SethDrake/monitor/main_module.brd

## EAGLE design main_module.brd (2017-12-04)

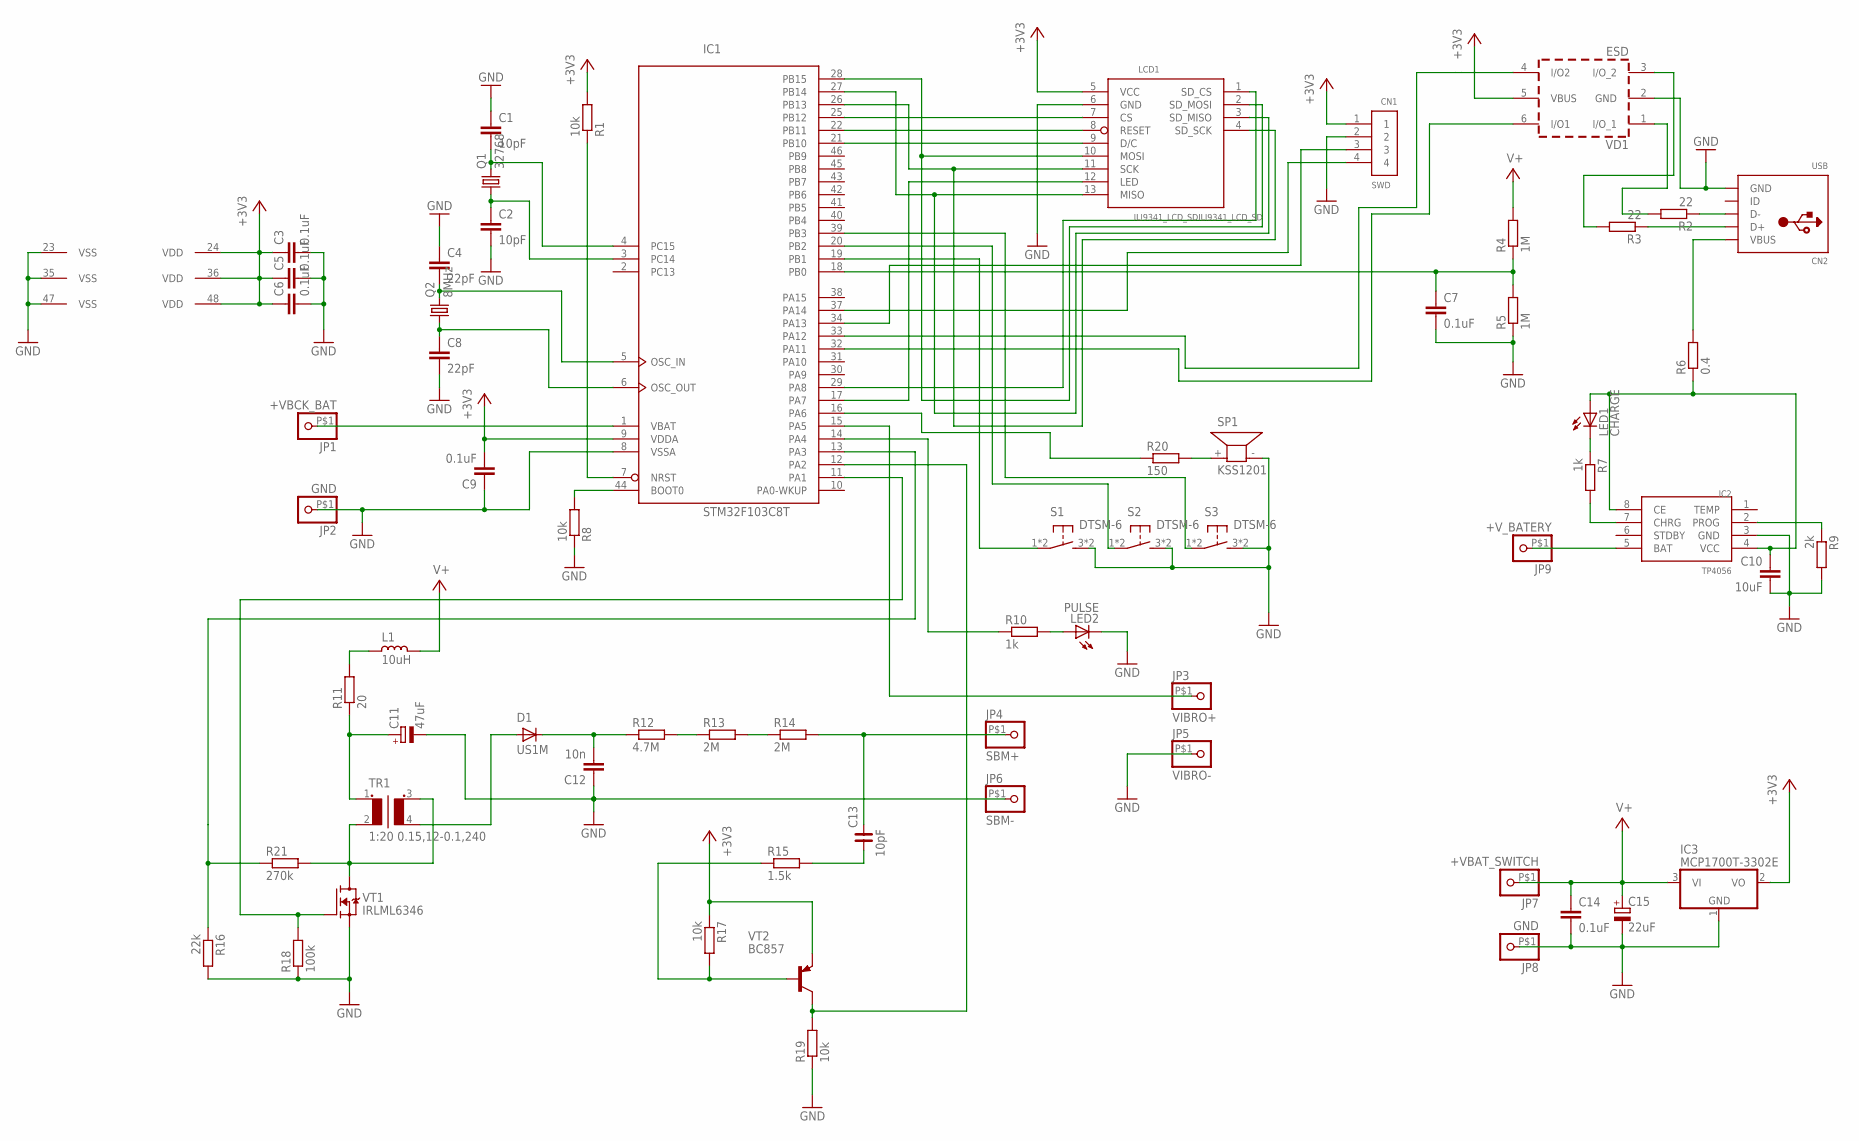
[picture p1: schematic main_module.sch]

Parts:
C1, C2: 10pF; C0805
C3, C5, C6, C7, C9, C14: 0.1uF; C0805
C4, C8: 22pF; C0805
C10: 10uF; C0805
C11: 47uF; C/6032-28R
C12: 10n; C1206
C13: 10pF; C1206
C15: 22uF; C/6032-28R
CN1: SWD; 1X04-BIG
CN2: USB; USB-MINIB
D1: US1M; SMA-DO214AC
IC1: STM32F103C8T; LQFP48
IC2: TP4056; SOP-8
IC3: MCP1700T-3302E; SOT23
JP1: +VBCK_BAT; 1X1-BIGPOGO
JP2, JP8: GND; 1X1-BIGPOGO
JP3: VIBRO+; 1X1-BIGPOGO
JP4: SBM+; 1X1-BIGPOGO
JP5: VIBRO-; 1X1-BIGPOGO
JP6: SBM-; 1X1-BIGPOGO
JP7: +VBAT_SWITCH; 1X1-BIGPOGO
JP9: +V_BATERY; 1X1-BIGPOGO
L1: 10uH; L0805
LCD1: ILI9341_LCD_SDILI9341_LCD_SD; ILI9341_LCD_SD
LED1: CHARGE; CHIP-LED0805
LED2: PULSE; LED3MM
Q1: 32768; HC49/S
Q2: 8MHz; HC49/S
R1, R8, R17, R19: 10k; M0805
R2, R3: 22; M0805
R4, R5: 1M; M0805
R6: 0.4; M1206
R7, R10: 1k; M0805
R9: 2k; M0805
R11: 20; M0805
R12: 4.7M; M0805
R13, R14: 2M; M0805
R15: 1.5k; M0805
R16: 22k; M0805
R18: 100k; M0805
R20: 150; M0805
R21: 270k; M0805
S1, S2, S3: DTSM-6
SP1: KSS1201
TR1: 1:20 0.15,12-0.1,240; RING-TRANS
VD1: ESD; SOT-23-6L
VT1: IRLML6346; SOT23
VT2: BC857; SOT23-BCE

Connections:
32OSC_IN: C1.2, IC1.4 (PC15), Q1.2
32OSC_OUT: C2.1, IC1.3 (PC14), Q1.1
+3V3: C3.1, C5.1, C6.1, C9.2, CN1.1, IC1.9 (VDDA), IC1.24 (VDD), IC1.36 (VDD), IC1.48 (VDD), IC3.2 (VO), LCD1.5 (VCC), R1.2, R17.1, VD1.5 (VBUS), VT2.E
+VBCK_BAT: IC1.1 (VBAT), JP1.P$1
+V_BATTERY: IC2.5 (BAT), JP9.P$1
BATT_CTRL: C7.1, IC1.18 (PB0), R4.1, R5.2
GND: C1.1, C2.2, C3.2, C4.1, C5.2, C6.2, C7.2, C8.2, C9.1, C10.2, C11.-, C12.1, C14.2, C15.-, CN1.2, CN2.GND, IC1.8 (VSSA), IC1.23 (VSS), IC1.35 (VSS), IC1.47 (VSS), IC2.3 (GND), IC3.1 (GND), JP2.P$1, JP5.P$1, JP6.P$1, JP8.P$1, LCD1.6 (GND), LED2.K (C), R5.1, R8.1, R9.2, R16.2, R18.1, R19.1, S1.3, S1.4 (3), S2.3, S2.4 (3), S3.3, S3.4 (3), SP1.- (2), VD1.2 (GND), VT1.2 (S)
HV_OUT: C12.2, D1.K (C), R12.1
HV_PULSE: IC1.12 (PA2), R19.2, VT2.C
HV_PUMP: IC1.11 (PA1), R18.2, VT1.1 (G)
HV_TEST: IC1.13 (PA3), R16.1, R21.1
HV_TR_OUT: D1.A, TR1.4 (S2)
KEY1: IC1.19 (PB1), S1.1, S1.2 (1)
KEY2: IC1.20 (PB2), S2.1, S2.2 (1)
KEY3: IC1.39 (PB3), S3.1, S3.2 (1)
LCD_BACKLIGHT: IC1.17 (PA7), LCD1.12 (LED)
LCD_CS: IC1.25 (PB12), LCD1.7 (CS)
LCD_RESET: IC1.22 (PB11), LCD1.8 (RESET)
LCD_RS: IC1.21 (PB10), LCD1.9 (D/C)
LED_PULSE: IC1.14 (PA4), R10.1
MISO: IC1.27 (PB14), LCD1.3 (SD_MISO), LCD1.13 (MISO)
MOSI: IC1.28 (PB15), LCD1.2 (SD_MOSI), LCD1.10 (MOSI)
unnamed: R13.2, R14.1
unnamed: R20.2, SP1.+ (1)
unnamed: R12.2, R13.1
unnamed: IC1.7 (NRST), R1.1
unnamed: L1.2, R11.2
unnamed: C13.1, R15.2
unnamed: C10.1, IC2.4 (VCC), IC2.8 (CE), LED1.A, R6.1
unnamed: LED2.A, R10.2
unnamed: R15.1, R17.2, VT2.B
unnamed: C11.+, R11.1, TR1.1
unnamed: IC1.44 (BOOT0), R8.2
unnamed: CN2.D-, R2.1
unnamed: CN2.D+, R3.1
unnamed: IC2.2 (PROG), R9.1
unnamed: R21.2, TR1.2, TR1.3 (S1), VT1.3 (D)
unnamed: IC2.7 (CHRG), R7.2
unnamed: LED1.C, R7.1
OSC_IN: C4.2, IC1.5 (OSC_IN), Q2.2
OSC_OUT: C8.1, IC1.6 (OSC_OUT), Q2.1
SBM+: C13.2, JP4.P$1, R14.2
SCK: IC1.26 (PB13), LCD1.4 (SD_SCK), LCD1.11 (SCK)
SD_CS: IC1.29 (PA8), LCD1.1 (SD_CS)
SOUND: IC1.16 (PA6), R20.1
SWCLK: CN1.4, IC1.37 (PA14)
SWDIO: CN1.3, IC1.34 (PA13)
USB_DM: IC1.32 (PA11), VD1.6 (I/O1)
USB_DM_PROT: R2.2, VD1.1 (I/O_1)
USB_DP: IC1.33 (PA12), VD1.4 (I/O2)
USB_DP_PROT: R3.2, VD1.3 (I/O_2)
USB_POWER: CN2.VBUS, R6.2
V+: C14.1, C15.+, IC3.3 (VI), JP7.P$1, L1.1, R4.2
VIBRO: IC1.15 (PA5), JP3.P$1

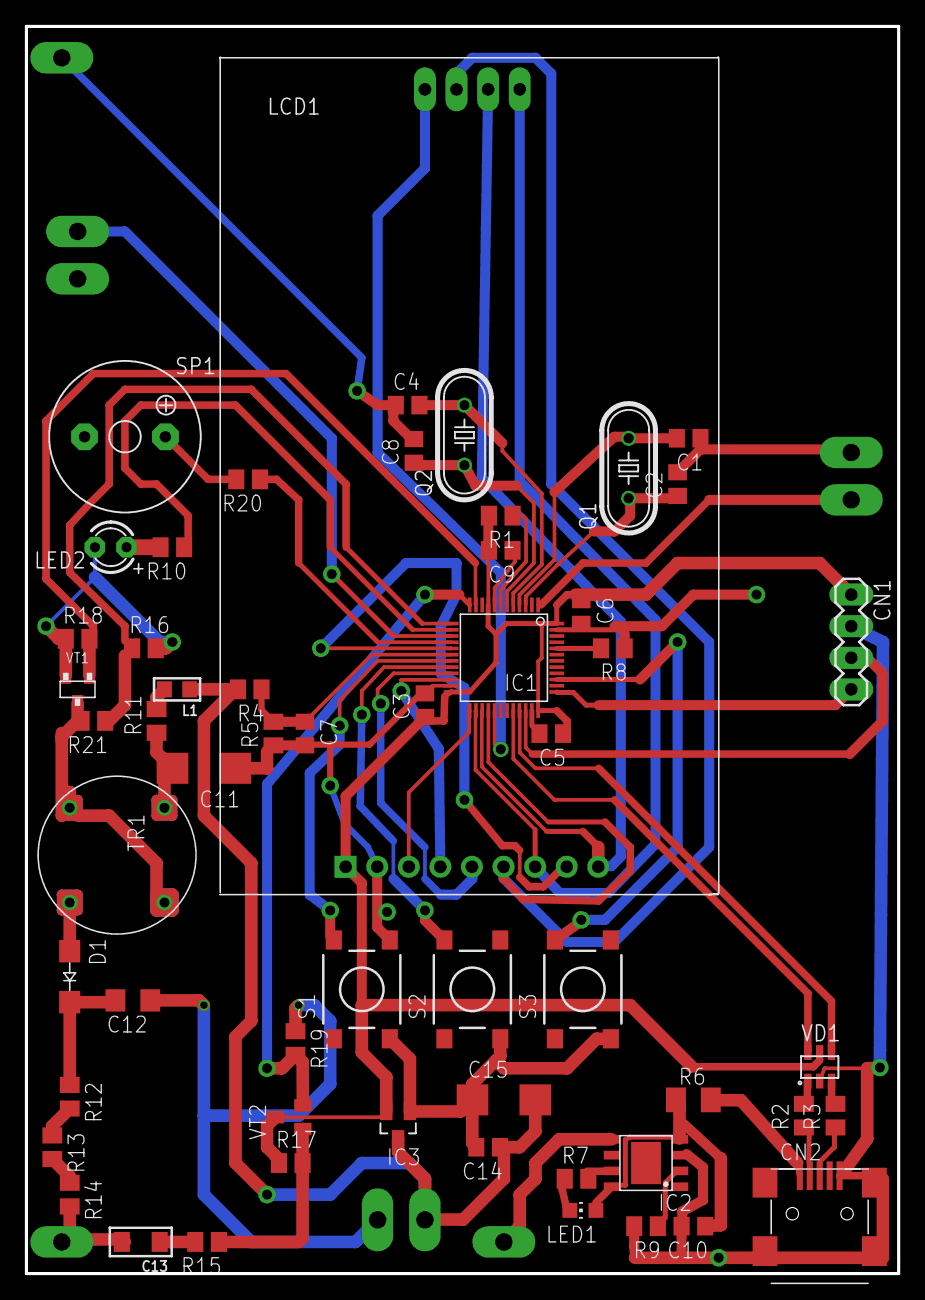
[picture p2: board main_module.brd from above]

Board: 2 copper layers, 70.2 x 100.3 mm, 65 parts (0 on the bottom side), 54 nets.
