SethDrake/monitor/main_module.0.1.brd

## EAGLE design main_module.0.1.brd (2017-04-18)

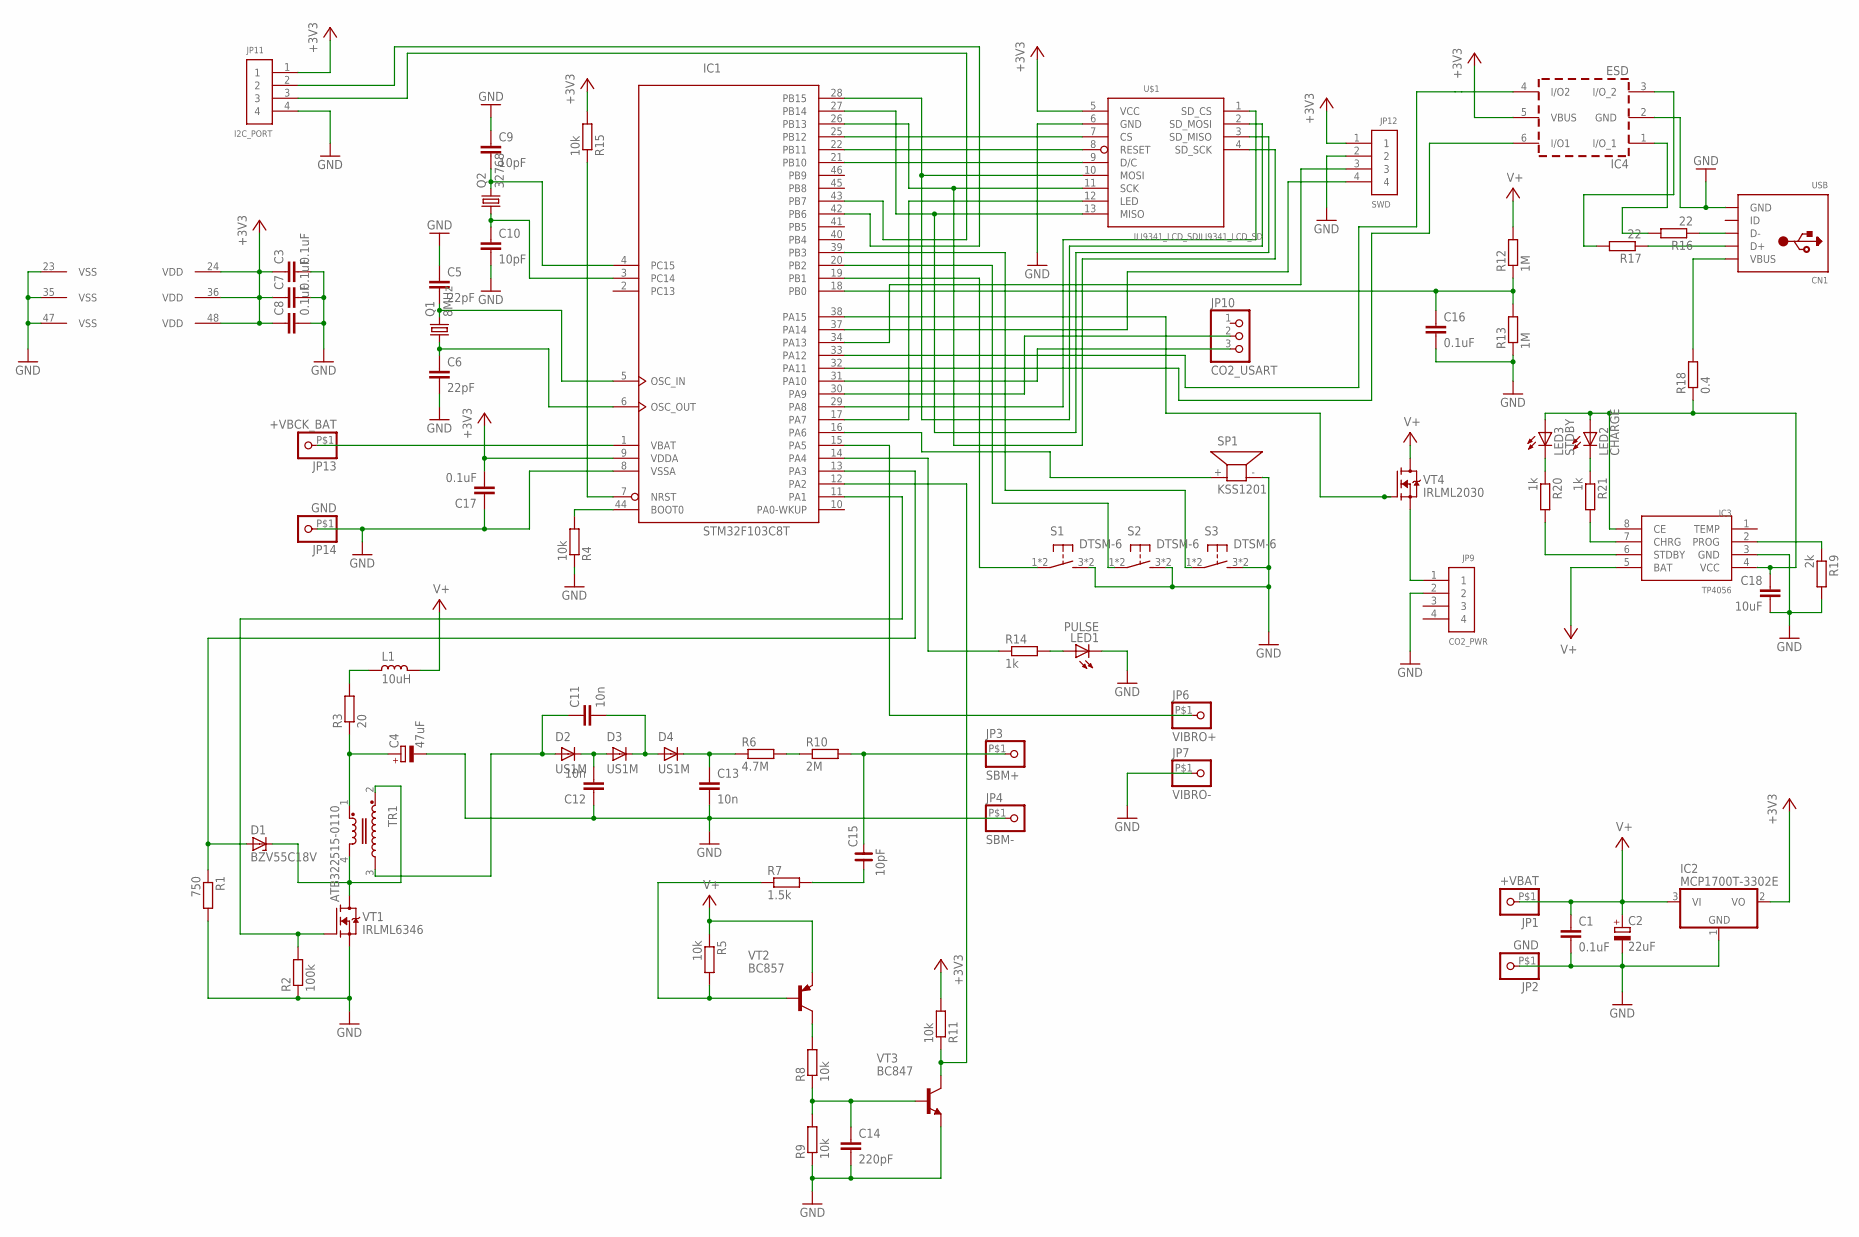
[picture p3: schematic main_module.0.1.sch]

Parts:
C1, C3, C7, C8, C16, C17: 0.1uF; C0805
C2: 22uF; C/6032-28R
C4: 47uF; C/6032-28R
C5, C6: 22pF; C0805
C9, C10: 10pF; C0805
C11, C12, C13: 10n; C1206
C14: 220pF; C0805
C15: 10pF; C1206
C18: 10uF; C0805
CN1: USB; USB-MINIB
D1: BZV55C18V; SOD80C
D2, D3, D4: US1M; SMA-DO214AC
IC1: STM32F103C8T; LQFP48
IC2: MCP1700T-3302E; SOT23
IC3: TP4056; SOP-8
IC4: ESD; SOT-23-6L
JP1: +VBAT; 1X1-BIGPOGO
JP2, JP14: GND; 1X1-BIGPOGO
JP3: SBM+; 1X1-BIGPOGO
JP4: SBM-; 1X1-BIGPOGO
JP6: VIBRO+; 1X1-BIGPOGO
JP7: VIBRO-; 1X1-BIGPOGO
JP9: CO2_PWR; 1X04-BIG
JP10: CO2_USART; 1X03
JP11: I2C_PORT; 1X04-BIG
JP12: SWD; 1X04-BIG
JP13: +VBCK_BAT; 1X1-BIGPOGO
L1: 10uH; L0805
LED1: PULSE; LED3MM
LED2: CHARGE; CHIP-LED0805
LED3: STDBY; CHIP-LED0805
Q1: 8MHz; HC49/S
Q2: 32768; HC49/S
R1: 750; M0805
R2: 100k; M0805
R3: 20; M0805
R4, R5, R8, R9, R11, R15: 10k; M0805
R6: 4.7M; M0805
R7: 1.5k; M0805
R10: 2M; M0805
R12, R13: 1M; M0805
R14, R20, R21: 1k; M0805
R16, R17: 22; M0805
R18: 0.4; M1206
R19: 2k; M0805
S1, S2, S3: DTSM-6
SP1: KSS1201
TR1: ATB322515-0110; ATB3225
U$1: ILI9341_LCD_SDILI9341_LCD_SD; ILI9341_LCD_SD
VT1: IRLML6346; SOT23
VT2: BC857; SOT23-BCE
VT3: BC847; SOT23
VT4: IRLML2030; SOT23

Connections:
32OSC_IN: C9.2, IC1.4 (PC15), Q2.2
32OSC_OUT: C10.1, IC1.3 (PC14), Q2.1
+3V3: C3.1, C7.1, C8.1, C17.2, IC1.9 (VDDA), IC1.24 (VDD), IC1.36 (VDD), IC1.48 (VDD), IC2.2 (VO), IC4.5 (VBUS), JP11.1, JP12.1, R11.2, R15.2, U$1.5 (VCC)
+VBCK_BAT: IC1.1 (VBAT), JP13.P$1
BATT_CTRL: C16.1, IC1.18 (PB0), R12.1, R13.2
CO2_PWR_CONTROL: IC1.38 (PA15), VT4.1 (G)
GND: C1.2, C2.-, C3.2, C4.-, C5.1, C6.2, C7.2, C8.2, C9.1, C10.2, C12.1, C13.2, C14.2, C16.2, C17.1, C18.2, CN1.GND, IC1.8 (VSSA), IC1.23 (VSS), IC1.35 (VSS), IC1.47 (VSS), IC2.1 (GND), IC3.3 (GND), IC4.2 (GND), JP2.P$1, JP4.P$1, JP7.P$1, JP9.2, JP11.4, JP12.2, JP14.P$1, LED1.K (C), R1.2, R2.1, R4.1, R9.1, R13.1, R19.2, S1.3, S1.4 (3), S2.3, S2.4 (3), S3.3, S3.4 (3), SP1.- (2), U$1.6 (GND), VT1.2 (S), VT3.2 (E)
HV_MUL_IN: C11.1, D2.A, TR1.3
HV_PULSE: IC1.12 (PA2), R11.1, VT3.3 (C)
HV_PUMP: IC1.11 (PA1), R2.2, VT1.1 (G)
HV_TEST: D1.A, IC1.13 (PA3), R1.1
I2C_SCL: IC1.42 (PB6), JP11.2
I2C_SDA: IC1.43 (PB7), JP11.3
KEY1: IC1.19 (PB1), S1.1, S1.2 (1)
KEY2: IC1.20 (PB2), S2.1, S2.2 (1)
KEY3: IC1.39 (PB3), S3.1, S3.2 (1)
LCD_BACKLIGHT: IC1.17 (PA7), U$1.12 (LED)
LCD_CS: IC1.25 (PB12), U$1.7 (CS)
LCD_RESET: IC1.22 (PB11), U$1.8 (RESET)
LCD_RS: IC1.21 (PB10), U$1.9 (D/C)
LED_PULSE: IC1.14 (PA4), R14.1
MISO: IC1.27 (PB14), U$1.3 (SD_MISO), U$1.13 (MISO)
MOSI: IC1.28 (PB15), U$1.2 (SD_MOSI), U$1.10 (MOSI)
unnamed: JP9.1, VT4.2 (S)
unnamed: C12.2, D2.K (C), D3.A
unnamed: C11.2, D3.K (C), D4.A
unnamed: C13.1, D4.K (C), R6.1
unnamed: R6.2, R10.1
unnamed: IC1.7 (NRST), R15.1
unnamed: L1.2, R3.2
unnamed: C15.1, R7.2
unnamed: C18.1, IC3.4 (VCC), IC3.8 (CE), LED2.A, LED3.A, R18.1
unnamed: LED1.A, R14.2
unnamed: R5.2, R7.1, VT2.B
unnamed: R8.2, VT2.C
unnamed: C14.1, R8.1, R9.2, VT3.1 (B)
unnamed: C4.+, R3.1, TR1.1
unnamed: IC1.44 (BOOT0), R4.2
unnamed: CN1.D-, R16.1
unnamed: CN1.D+, R17.1
unnamed: IC3.2 (PROG), R19.1
unnamed: D1.C, TR1.2, TR1.4, VT1.3 (D)
unnamed: IC3.7 (CHRG), R21.2
unnamed: LED2.C, R21.1
unnamed: LED3.C, R20.1
unnamed: IC3.6 (STDBY), R20.2
OSC_IN: C5.2, IC1.5 (OSC_IN), Q1.2
OSC_OUT: C6.1, IC1.6 (OSC_OUT), Q1.1
SBM+: C15.2, JP3.P$1, R10.2
SCK: IC1.26 (PB13), U$1.4 (SD_SCK), U$1.11 (SCK)
SD_CS: IC1.29 (PA8), U$1.1 (SD_CS)
SOUND: IC1.16 (PA6), SP1.+ (1)
SWCLK: IC1.37 (PA14), JP12.4
SWDIO: IC1.34 (PA13), JP12.3
USART_RX: IC1.31 (PA10), JP10.3
USART_TX: IC1.30 (PA9), JP10.2
USB_DM: IC1.32 (PA11), IC4.6 (I/O1)
USB_DM_PROT: IC4.1 (I/O_1), R16.2
USB_DP: IC1.33 (PA12), IC4.4 (I/O2)
USB_DP_PROT: IC4.3 (I/O_2), R17.2
USB_POWER: CN1.VBUS, R18.2
V+: C1.1, C2.+, IC2.3 (VI), IC3.5 (BAT), JP1.P$1, L1.1, R5.1, R12.2, VT2.E, VT4.3 (D)
VIBRO: IC1.15 (PA5), JP6.P$1

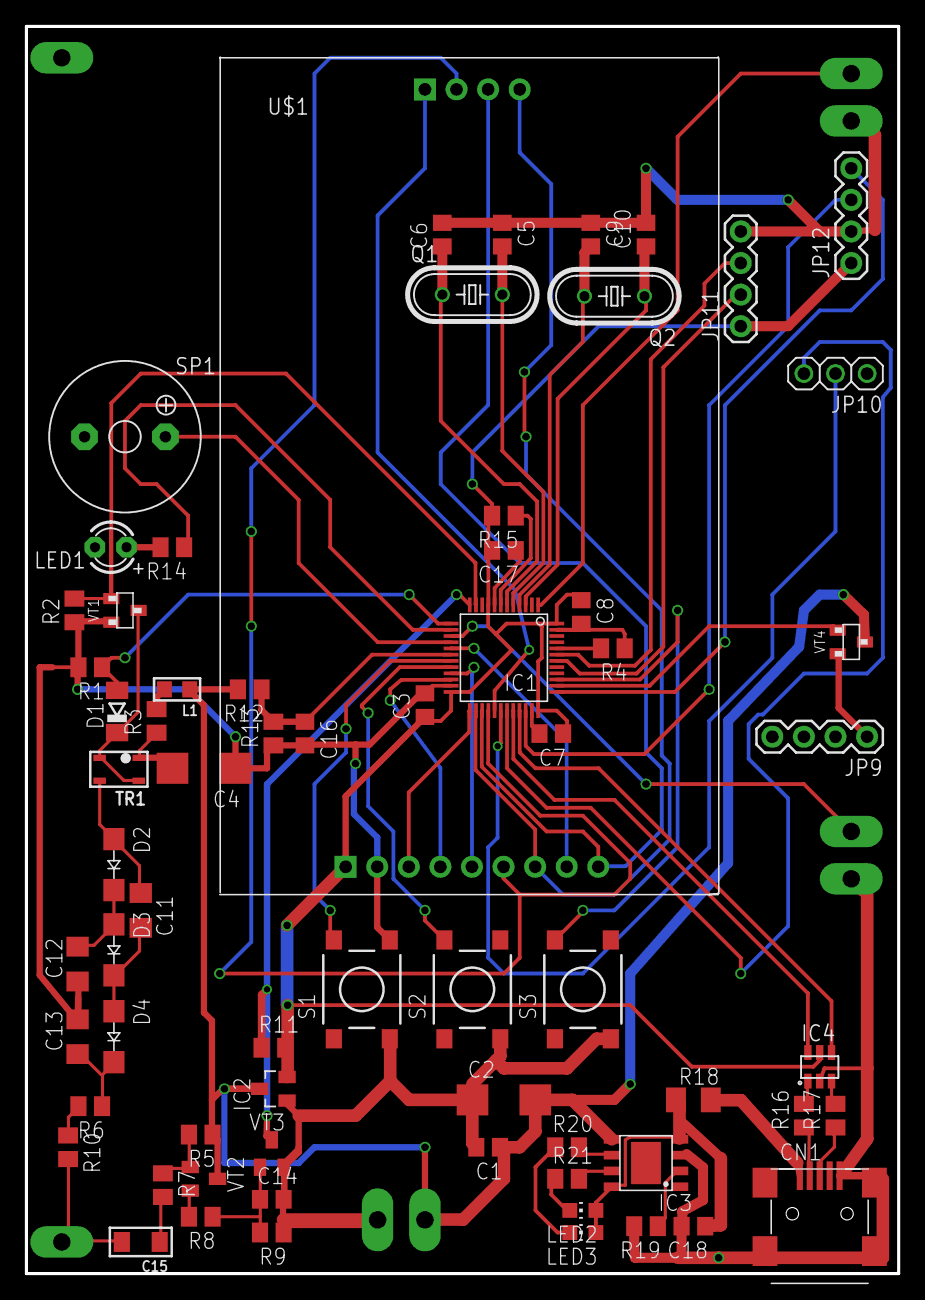
[picture p4: board main_module.0.1.brd from above]

Board: 2 copper layers, 70.2 x 100.3 mm, 76 parts (0 on the bottom side), 63 nets.
