SethDrake/monitor/Firmware/src/interrupts.cpp

#include "interrupts.h"
#include "stm32f10x_exti.h"
#include "stm32f10x_rtc.h"
#include <stm32f10x_adc.h>
#include <stm32f10x_pwr.h>
#include "delay.h"
#include "objects.h"

#ifdef __cplusplus
extern "C" {
#endif

/**
* @brief   This function handles NMI exception.
* @param  None
* @retval None
*/
void __attribute__((interrupt("IRQ"))) NMI_Handler(void)
{
}

void __attribute__((interrupt("IRQ"))) HardFault_Handler(void)
{
	__ASM("TST LR, #4");
	__ASM("ITE EQ");
	__ASM("MRSEQ R0, MSP");
	__ASM("MRSNE R0, PSP");
	__ASM("B hard_fault_handler");
}

/**
* @brief  This function handles Memory Manage exception.
* @param  None
* @retval None
*/
void __attribute__((interrupt("IRQ"))) MemManage_Handler(void)
{
	custom_fault_handler("MEM MANAGE EXCEPTION -- SYSTEM STOPPED");
	/* Go to infinite loop when Memory Manage exception occurs */
	while (1);
}

/**
* @brief  This function handles Bus Fault exception.
* @param  None
* @retval None
*/void __attribute__((interrupt("IRQ"))) BusFault_Handler(void)
{
	custom_fault_handler("BUS FAULT --- SYSTEM STOPPED");
	/* Go to infinite loop when Bus Fault exception occurs */
	while (1);
}

/**
* @brief  This function handles Usage Fault exception.
* @param  None
* @retval None
*/
void __attribute__((interrupt("IRQ"))) UsageFault_Handler(void)
{
	custom_fault_handler("USAGE FAULT --- SYSTEM STOPPED");
	/* Go to infinite loop when Usage Fault exception occurs */
	while (1);
}

/*void __attribute__((interrupt("IRQ"))) SVC_Handler(void)
{
}*/

void __attribute__((interrupt("IRQ"))) DebugMon_Handler(void)
{
}

/*void __attribute__((interrupt("IRQ"))) PendSV_Handler(void)
{
}*/

void __attribute__((interrupt("IRQ"))) SysTick_Handler(void) {
	DelayManager::SysTickIncrement();
}

void __attribute__((interrupt("IRQ")))  DMA1_Channel5_IRQHandler(void)
{
	if (display.IsDataSending()) {
		display.DMATXInterrupt();
	}
}

void __attribute__((interrupt("IRQ")))  EXTI2_IRQHandler(void)
{
	if (EXTI_GetITStatus(EXTI_Line2) != RESET)
	{
		EXTI_ClearITPendingBit(EXTI_Line2);
		processGeigerImpulse();
	}
}
	
void __attribute__((interrupt("IRQ")))  EXTI3_IRQHandler(void)
{
	if (EXTI_GetITStatus(EXTI_Line3) != RESET)
	{
		EXTI_ClearITPendingBit(EXTI_Line3);
		processHVTestImpulse();
	}
}	
	
void __attribute__((interrupt("IRQ")))  EXTI17_IRQHandler(void)
{
	if (EXTI_GetITStatus(EXTI_Line17) != RESET)
	{
		EXTI_ClearITPendingBit(EXTI_Line17);
	}
}
	
void __attribute__((interrupt("IRQ")))  RTC_Alarm_IRQHandler(void)
{
	if (RTC_GetITStatus(RTC_IT_ALR) != RESET)
	{
		RTC_SetAlarm(RTC_GetCounter() + 1);
		
		RTC_ClearITPendingBit(RTC_IT_ALR);
		EXTI_ClearITPendingBit(EXTI_Line17);

		/*if (PWR_GetFlagStatus(PWR_FLAG_WU) != RESET)
		{
			PWR_ClearFlag(PWR_FLAG_WU);
		}*/
		processPeriodicTasks();
	}
}
	
/*void __attribute__((interrupt("IRQ")))  RTC_IRQHandler(void)
{
	if (RTC_GetITStatus(RTC_IT_SEC) != RESET)
	{
		RTC_ClearITPendingBit(RTC_IT_SEC);
		//processPeriodicTasks();	
	}
}*/
	
void __attribute__((interrupt("IRQ"))) ADC1_2_IRQHandler(void) {
	if (ADC_GetITStatus(ADC1, ADC_IT_EOC)) {
		ADC_ClearITPendingBit(ADC1, ADC_IT_EOC);
		readADCValue();
	}
}

void custom_fault_handler(const char * title)
{
	
	if (display.isReady())
	{
		
		display.setLandscape();
		display.setDisableDMA(1);
		display.setColor(WHITE, BLUE);
		display.clear(BLUE);
		display.printf(10, 220, title);
	}
}

void hard_fault_handler(unsigned int * hardfault_args)
{
	unsigned int stacked_r0;
	unsigned int stacked_r1;
	unsigned int stacked_r2;
	unsigned int stacked_r3;
	unsigned int stacked_r12;
	unsigned int stacked_lr;
	unsigned int stacked_pc;
	unsigned int stacked_psr;

	stacked_r0 = ((unsigned long) hardfault_args[0]);
	stacked_r1 = ((unsigned long) hardfault_args[1]);
	stacked_r2 = ((unsigned long) hardfault_args[2]);
	stacked_r3 = ((unsigned long) hardfault_args[3]);

	stacked_r12 = ((unsigned long) hardfault_args[4]);
	stacked_lr = ((unsigned long) hardfault_args[5]);
	stacked_pc = ((unsigned long) hardfault_args[6]);
	stacked_psr = ((unsigned long) hardfault_args[7]);

	custom_fault_handler("HARD FAULT DETECTED --- SYSTEM STOPPED");
	if (display.isReady())
	{
		display.printf(10, 200, "R0 = %x", stacked_r0);
		display.printf(10, 185, "R1 = %x", stacked_r1);
		display.printf(10, 170, "R2 = %x", stacked_r2);
		display.printf(10, 155, "R3 = %x", stacked_r3);
		display.printf(10, 140, "R12 = %x", stacked_r12);
		display.printf(10, 125, "LR [R14] = %x", stacked_lr);
		display.printf(10, 110, "PC [R15] = %x", stacked_pc);
		display.printf(10, 95, "PSR = %x", stacked_psr);
		display.printf(10, 80, "BFAR = %x", (*((volatile unsigned long *)(0xE000ED38))));
		display.printf(10, 65, "CFSR = %x", (*((volatile unsigned long *)(0xE000ED28))));
		display.printf(10, 50, "HFSR = %x", (*((volatile unsigned long *)(0xE000ED2C))));
		display.printf(10, 35, "DFSR = %x", (*((volatile unsigned long *)(0xE000ED30))));
		display.printf(10, 20, "AFSR = %x", (*((volatile unsigned long *)(0xE000ED3C))));
		display.printf(10, 5, "SCB_SHCSR = %x", SCB->SHCSR);
	}

	while (1);
}

#ifdef __cplusplus
}
#endif
