SethDrake/monitor/Firmware/src/radiation.h

#pragma once
#ifndef __RADIATION_H_
#define __RADIATION_H_

#include "stm32f10x.h"
#include "objects.h"

#define impulse_threshold 10

class RadiationCounter {
public:
	RadiationCounter();
	~RadiationCounter();
	
	void TickImpulse(void);
	void TickOneSecond(void);
	void IncPumpActiveDuration(void);
	uint32_t GetCurrentLevelMkRh(void);
	uint32_t GetMaxLevelTodayMkRh(void);
	uint16_t GetLastSecondImpulseCount(void);
	uint16_t GetCurrentSecondImpulseCount(void);
	volatile uint16_t* GetPerSecondCounts(void);
	volatile uint16_t* GetPerMinuteCounts(void);
	volatile uint16_t* GetPerHourCounts(void);
	uint32_t GetTotalSeconds(void);
	void ClearFullDose(void);
	uint32_t GetFullDose(void);
	uint32_t GetFullDoseDays(void);
	void SetTotalSeconds(uint32_t val);
	time_s* GetTime(void);
	void SetTime(time_s tm);
	uint8_t GetCountInterval(void);
	uint8_t GetValidateInterval(void);
	uint8_t GetPumpActivDurationPerMinute(void);
	bool HasPulsesInLast5Seconds(void);
	uint8_t GetDaysInMonth(uint8_t month, uint16_t year);
	uint32_t GetUptime(void);
	void ClearUptime(void);
	
protected:
	void CalculateCurrentLevelMkRh(void);

private:
	volatile uint16_t counts[122];
	volatile uint16_t radPerMinutes[62];
	volatile uint16_t radPerHours[26];
	volatile uint16_t radPerDays[33];
	volatile uint32_t levelsPerYear[14];
	volatile uint32_t currentLevel;
	volatile uint32_t fullDose;
	volatile uint16_t fullDoseDays;
	volatile uint32_t sumCountsForInterval;
	volatile uint32_t maxLevel;
	volatile uint32_t maxLevelToday;
	time_s   time;
	volatile uint8_t  countTime;	
	volatile uint8_t  validateInterval;	
	volatile uint8_t  lastMinutePumpActiveSeconds;	
	volatile uint8_t  pumpActiveSeconds;	
	volatile uint32_t  uptime;	
};

#endif
