SethDrake/monitor/(commit log)

2017-09-23 power scheme improvement
    [main_module.brd, main_module.sch]
2019-09-02 project fixes added docs
    [delay.cpp, main.cpp, objects.h, radiation.cpp, screens.cpp, screens.h, settings.cpp, settings.h]
2019-09-06 low battery shutdown and watchdog improvements
2019-09-06 adjust low battery shutdown threshold
2019-09-20 fix batt adc coeff
    [main.cpp]
