SethDrake/monitor/(notices)

Notices in the files:
parts and their libraries:
rc-master-smd: Copyright (C) 2007, Bob Starr
atb3225-tdk: Copyright (C) 2008, Bob Starr
